bidouilles/bGeigieNano/assembly/xGeigieNano.jpg

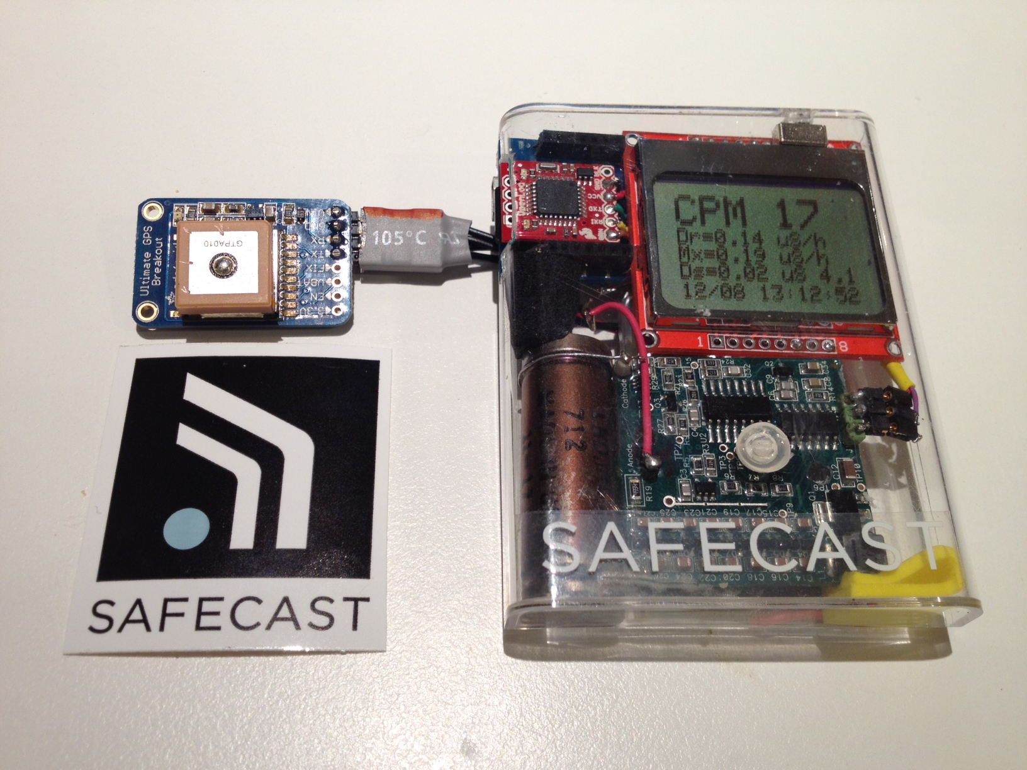
assembly/xGeigieNano.jpg
