bidouilles/bGeigieNano/assembly/xGeigieNano_kit.jpg

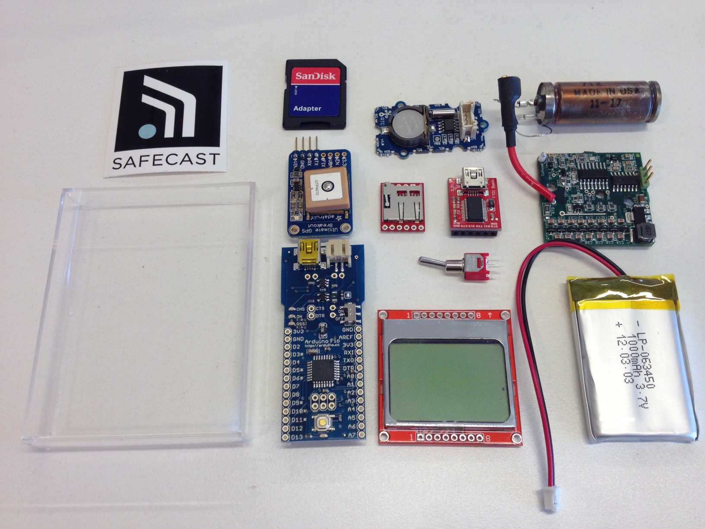
assembly/xGeigieNano_kit.jpg
