bidouilles/bGeigieNano/bGeigieNano.ino

/*
   The bGeigie-nano
   A device for car-borne radiation measurement (aka Radiation War-driving).

   Copyright (c) 2012, Lionel Bergeret
   Copyright (c) 2011, Robin Scheibler aka FakuFaku, Christopher Wang aka Akiba
   All rights reserved.

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
   THIS SOFTWARE IS PROVIDED BY THE COPYRIGHT HOLDERS AND CONTRIBUTORS "AS IS" AND
   ANY EXPRESS OR IMPLIED WARRANTIES, INCLUDING, BUT NOT LIMITED TO, THE IMPLIED
   WARRANTIES OF MERCHANTABILITY AND FITNESS FOR A PARTICULAR PURPOSE ARE
   DISCLAIMED. IN NO EVENT SHALL <COPYRIGHT HOLDER> BE LIABLE FOR ANY
   DIRECT, INDIRECT, INCIDENTAL, SPECIAL, EXEMPLARY, OR CONSEQUENTIAL DAMAGES
   (INCLUDING, BUT NOT LIMITED TO, PROCUREMENT OF SUBSTITUTE GOODS OR SERVICES;
   LOSS OF USE, DATA, OR PROFITS; OR BUSINESS INTERRUPTION) HOWEVER CAUSED AND
   ON ANY THEORY OF LIABILITY, WHETHER IN CONTRACT, STRICT LIABILITY, OR TORT
   (INCLUDING NEGLIGENCE OR OTHERWISE) ARISING IN ANY WAY OUT OF THE USE OF THIS
   SOFTWARE, EVEN IF ADVISED OF THE POSSIBILITY OF SUCH DAMAGE.
*/

#include <limits.h>
#include <SoftwareSerial.h>
#include <math.h>
#include <stdlib.h>
#include <avr/wdt.h>
#include <EEPROM.h>
#include "TinyGPS.h"

#include "NanoSetup.h"
#include "NanoConfig.h"
#include "NanoDebug.h"

// OLED settings --------------------------------------------------------------
#if ENABLE_SSD1306
#ifndef OLED_SPI_MODE
#include <Wire.h>
#endif
#include <Adafruit_GFX.h>
#include <Adafruit_SSD1306.h>

#ifdef OLED_SPI_MODE
Adafruit_SSD1306 display(OLED_DATA, OLED_CLK, OLED_DC, OLED_RESET, OLED_CS);
#else
Adafruit_SSD1306 display(OLED_RESET);
#endif

#if (SSD1306_LCDHEIGHT != 32)
#error("Height incorrect, please fix Adafruit_SSD1306.h!");
#endif

#if (_SS_MAX_RX_BUFF < 128)
#error "SoftwareSerial RX buffer too small for TinyGPS NMEA sentences. Set _SS_MAX_RX_BUFF >= 128 in SoftwareSerial.h."
#endif

// For distance computation
bool gps_fix_first = true;
float gps_last_lon = 0, gps_last_lat = 0;
unsigned long int gps_distance = 0;
#endif

// Geiger settings ------------------------------------------------------------
#define TIME_INTERVAL 5000
#define LINE_SZ 120  // BNRDD with all numeric fields at max width hits ~120 B
#define BUFFER_SZ 12
#define STRBUFFER_SZ 32
#define NX (60000 / TIME_INTERVAL) // 1-minute sliding window in TIME_INTERVAL-sized bins
#define AVAILABLE 'A'  // indicates geiger data are ready (available)
#define VOID      'V'  // indicates geiger data not ready (void)

// log file headers
#define LOGFILE_HEADER "# NEW LOG\n# format="
char logfile_name[13];  // placeholder for filename
bool logfile_ready = false;

// geiger statistics
unsigned long shift_reg[NX] = {0};
unsigned long reg_index = 0;
unsigned long total_count = 0;
unsigned long max_count = 0;
unsigned long uptime = 0;
int str_count = 0;
char geiger_status = VOID;

// the line buffer for serial receive and send
static char line[LINE_SZ];
static char strbuffer[STRBUFFER_SZ];

// Pulse counter --------------------------------------------------------------
#if ENABLE_HARDWARE_COUNTER
// Hardware counter
#include "HardwareCounter.h"
HardwareCounter hwc(HARDWARE_COUNTER_TIMER1, TIME_INTERVAL);
#else
// Interrupt counter
#include "InterruptCounter.h"
#endif

#if ENABLE_HARDWARE_COUNTER
#if ENABLE_SLEEPMODE
#define IS_READY (1)
#else
#define IS_READY (hwc.available())
#endif
#else
#define IS_READY (interruptCounterAvailable())
#endif

// Last counter value, for delta-based sampling that does not race with
// the hardware reset.
COUNTER_TYPE prev_count = 0;

// OpenLog settings -----------------------------------------------------------
#if ENABLE_OPENLOG
#define OPENLOG_RETRY 200
SoftwareSerial OpenLog(OPENLOG_RX_PIN, OPENLOG_TX_PIN);
static const int resetOpenLog = OPENLOG_RST_PIN;
#endif
bool openlog_ready = false;

// Gps settings ------------------------------------------------------------
TinyGPS gps(true);
#define GPS_INTERVAL 1000
char gps_status = VOID;

#if ENABLE_SOFTGPS
SoftwareSerial gpsSerial(GPS_RX_PIN, GPS_TX_PIN);
#endif

// Gps data buffers
static char lat[BUFFER_SZ];
static char lon[BUFFER_SZ];

// MTK33x9 chipset
#define PMTK_SET_NMEA_UPDATE_1HZ "$PMTK220,1000*1F"
#define PMTK_SET_NMEA_OUTPUT_ALLDATA "$PMTK314,1,1,1,1,1,1,0,0,0,0,0,0,0,0,0,0,0,0,0*28"
#define PMTK_SET_NMEA_OUTPUT_RMCGGA "$PMTK314,0,1,0,1,0,0,0,0,0,0,0,0,0,0,0,0,0,0,0*28"
#define SBAS_ENABLE "$PMTK313,1*2E\r\n"
#define DGPS_WAAS_ON "$PMTK301,2*2E\r\n"

#if ENABLE_STATIC_GPS
#include <avr/pgmspace.h>
// GPS test sentences
char strGPRMC[] PROGMEM = "$GPRMC,201547.000,A,3014.5527,N,09749.5808,W,0.24,163.05,040109,,*1A";
char strGPGGA[] PROGMEM = "$GPGGA,201548.000,3014.5529,N,09749.5808,W,1,07,1.5,225.6,M,-22.5,M,18.8,0000*78";
char *teststrs[2] = {strGPRMC, strGPGGA};

static void sendstring(TinyGPS &gps, const PROGMEM char *str)
{
  while (true)
  {
    char c = pgm_read_byte_near(str++);
    if (!c) break;
    gps.encode(c);
  }
  gps.encode('\r');
  gps.encode('\n');
}
#endif

// Function definitions ---------------------------------------------------------
// Atmel Tips and Tricks: 3.6 Tip #6 – Access types: Static
static unsigned long cpm_gen();
static bool gps_gen_filename(TinyGPS &gps, char *buf);
static bool gps_gen_timestamp(TinyGPS &gps, char *buf, unsigned long cpm, unsigned long cpb);
static char checksum(char *s, int N);
#if ENABLE_OPENLOG
static void setupOpenLog();
static void createFile(char *fileName);
#endif
static void gps_program_settings();
static float read_voltage(int pin);
static unsigned long elapsedTime(unsigned long startTime);
#if ENABLE_100M_TRUNCATION
static void truncate_100m(char *latitude, char *longitude);
#endif

// Sleep mode -----------------------------------------------------------------
#if ENABLE_SLEEPMODE
#include <avr/sleep.h>
#include <avr/power.h>

volatile int f_wdt=1;

ISR(WDT_vect)
{
  if(f_wdt == 0)
  {
    f_wdt=1;
  }
  else
  {
    DEBUG_PRINTLN("WARNING: WDT Overrun");
  }
}

void enableSleepTimer(void)
{
  cli();
  wdt_reset();

  // Setup WDT
  // Clear the reset flag
  MCUSR &= ~(1<<WDRF);

  // Set WDCE (4 clock cycles updates)
  WDTCSR |= (1<<WDCE) | (1<<WDE);

  // Set new watchdog timeout prescaler value
  WDTCSR = 1<<WDP3; // 4.0 seconds

  // Enable the WD interrupt
  WDTCSR |= _BV(WDIE);

  sei();
}

void disableSleepTimer(void)
{
  cli();
  wdt_reset();

  // Setup WDT
  // Clear the reset flag
  MCUSR &= ~(1<<WDRF);

  // Keep old prescaler setting to prevent unintentional time-out
  WDTCSR |= (1<<WDCE) | (1<<WDE);

  // Disable the WD interrupt
  WDTCSR |= 0x00;

  sei();
}

void enterSleep(void)
{
  power_all_disable();
  set_sleep_mode(SLEEP_MODE_STANDBY); // keep oscillator active

  // Enable and enter sleep mode
  sleep_enable();
  sleep_mode();

  // The program will continue from here after the WDT timeout

  // Disable sleep and re-enable the peripherals
  sleep_disable();
  power_all_enable();
}
#endif

// Nano Settings --------------------------------------------------------------
static ConfigType config;
static DoseType dose;
#if ENABLE_OPENLOG
NanoSetup nanoSetup(OpenLog, config, dose, line, LINE_SZ);
#endif

// ****************************************************************************
// Setup
// ****************************************************************************
void setup()
{
  pinMode(GPS_LED_PIN, OUTPUT);
  pinMode(GEIGIE_TYPE_PIN, INPUT);

  Serial.begin(9600);

#ifndef ENABLE_SLEEPMODE
  // enable and reset the watchdog timer
  wdt_enable(WDTO_8S);
  wdt_reset();
#endif

#if ENABLE_OPENLOG
  // Load EEPROM settings. nanoSetup holds an OpenLog reference internally,
  // so it can only be constructed when OpenLog is compiled in.
  nanoSetup.initialize();

  DEBUG_PRINTLN("Initializing OpenLog.");
  OpenLog.begin(9600);
  setupOpenLog();
  if (openlog_ready) {
    nanoSetup.loadFromFile("SAFECAST.TXT");
  }
#endif

  DEBUG_PRINTLN("Initializing pulse counter.");

#if ENABLE_HARDWARE_COUNTER
  // Start the Pulse Counter!
  hwc.start();
  prev_count = hwc.count();
#else
  // Create pulse counter
  interruptCounterSetup(INTERRUPT_COUNTER_PIN, TIME_INTERVAL);

  // And now Start the Pulse Counter!
  interruptCounterReset();
  prev_count = interruptCounterCount();
#endif

#if ENABLE_SOFTGPS
  DEBUG_PRINTLN("Initializing GPS.");
  gpsSerial.begin(9600);

  // Put GPS serial in listen mode
  gpsSerial.listen();

  // initialize and program the GPS module
  gps_program_settings();
#endif

  DEBUG_PRINT("Devide id = ");
  DEBUG_PRINTLN(config.device_id);

#if ENABLE_EEPROM_DOSE
  EEPROM_readAnything(BMRDD_EEPROM_DOSE, dose);
  if (dose.total_time != 0) {
    dtostrf((float)( ((dose.total_count/(dose.total_time/60.0))/config.cpm_factor) * (dose.total_time/3600.0) ), 0, 2, strbuffer);
    DEBUG_PRINT("Total dose = ");
    DEBUG_PRINT(strbuffer);
    DEBUG_PRINTLN(" uSv");
  } else {
    DEBUG_PRINTLN("Total dose = 0.00 uSv");
  }
#endif

  // setup analog reference to read battery and boost voltage
  analogReference(INTERNAL);

#if ENABLE_SLEEPMODE
  enableSleepTimer();
#endif

#if ENABLE_SSD1306
  display.begin(SSD1306_SWITCHCAPVCC, 0x3C);

  // show splashscreen logo
  display.display();

  delay(1000);

  // show 2nd splashscreen
  display.clearDisplay();

  display.setTextColor(WHITE);
  display.setTextSize(1);
  sprintf_P(strbuffer, PSTR("Geigie Nano %s"), NANO_VERSION);
  display.setCursor((128-((strlen(strbuffer)+1)*6))/2, 0);
  if (config.type == GEIGIE_TYPE_B) {
    display.print("b");
  } else {
    display.print("x");
  }
  display.print(strbuffer);

  display.setTextSize(2);
  display.setCursor(40, 8);
  sprintf_P(strbuffer, PSTR("#%04d"), config.device_id);
  display.print(strbuffer);

  display.setTextSize(1);
  if (strlen(config.user_name)) {
    display.setCursor((128-(strlen(config.user_name)*6))/2, 24); // textsize*8
    display.print(config.user_name);
  }
  display.display();
#endif

  DEBUG_PRINTLN("Setup completed.");
}

// ****************************************************************************
// Main loop
// ****************************************************************************
void loop()
{
  bool gpsReady = false;

#if ENABLE_GEIGIE_SWITCH
  // Check geigie mode switch
  if (analogRead(GEIGIE_TYPE_PIN) > GEIGIE_TYPE_THRESHOLD) {
    config.type = GEIGIE_TYPE_X; // xGeigie
  } else {
    config.type = GEIGIE_TYPE_B; // bGeigie
  }
#endif

#if ENABLE_SLEEPMODE
  if(f_wdt == 1)
  {
    disableSleepTimer();
#endif

#if ENABLE_SOFTGPS
  // Put GPS serial in listen mode
  gpsSerial.listen();
#endif

  // For one second we parse GPS sentences
  for (unsigned long start = millis(); (elapsedTime(start) < GPS_INTERVAL) and !IS_READY;)
  {
#if ENABLE_STATIC_GPS
    for (int i=0; i<2; ++i)
    {
      sendstring(gps, teststrs[i]);
    }
#else
#if ENABLE_SOFTGPS
    while (gpsSerial.available())
    {
      char c = gpsSerial.read();
#else
    while (Serial.available())
    {
      char c = Serial.read();
#endif

#if ENABLE_GPS_NMEA_LOG
      Serial.print(c); // uncomment this line if you want to see the GPS data flowing
#endif
      if (gps.encode(c)) // Did a new valid sentence come in?
        gpsReady = true;
    }
#endif
  }

#if ENABLE_SLEEPMODE
  // Will wakeup in 4 seconds from now
  enableSleepTimer();
#endif

  if ((gpsReady) || (gps_status == AVAILABLE)) {
    digitalWrite(GPS_LED_PIN, HIGH);
  } else {
    digitalWrite(GPS_LED_PIN, LOW);
  }

  // generate CPM every TIME_INTERVAL seconds
  if IS_READY {
      unsigned long cpm=0, cpb=0;

#ifndef ENABLE_SLEEPMODE
      // first, reset the watchdog timer
      wdt_reset();
#endif

      // read the current free-running counter, then derive this bin's count
      // by diffing against the previous read. The hardware is never reset
      // between samples, so pulses arriving during the read can't be lost.
      // The unsigned subtraction is correct across one wrap of COUNTER_TYPE.
#if ENABLE_HARDWARE_COUNTER
      COUNTER_TYPE this_count = hwc.count();
#else
      COUNTER_TYPE this_count = interruptCounterCount();
#endif
      cpb = (COUNTER_TYPE)(this_count - prev_count);
      prev_count = this_count;

      // insert count in sliding window and compute CPM
      shift_reg[reg_index] = cpb;     // put the count in the correct bin
      reg_index = (reg_index+1) % NX; // increment register index
      cpm = cpm_gen();                // compute sum over all bins

      // update the total counter
      total_count += cpb;
      uptime += TIME_INTERVAL / 1000;

      // update max cpm
      if (cpm > max_count) max_count = cpm;

#if ENABLE_EEPROM_DOSE
      dose.total_count += cpb;
      dose.total_time += TIME_INTERVAL / 1000;
      // Persist on every WRITETIME elapsed seconds. Tracking a separate
      // counter avoids the modulus pitfall — % would silently never fire
      // if TIME_INTERVAL doesn't evenly divide WRITETIME.
      static unsigned long dose_secs_since_write = 0;
      dose_secs_since_write += TIME_INTERVAL / 1000;
      if (dose_secs_since_write >= BMRDD_EEPROM_DOSE_WRITETIME) {
        EEPROM_writeAnything(BMRDD_EEPROM_DOSE, dose);
        dose_secs_since_write = 0;
      }
#endif

      // set status of Geiger
      if (str_count < NX)
      {
        geiger_status = VOID;
        str_count++;
      } else if (cpm == 0) {
        geiger_status = VOID;
      } else {
        geiger_status = AVAILABLE;
      }

#if ENABLE_WAIT_GPS_FOR_LOG
      if ((!logfile_ready) && (gps_status == AVAILABLE))
#else
      if (!logfile_ready)
#endif
      {
         if (gps_gen_filename(gps, logfile_name)) {
           logfile_ready = true;

#if ENABLE_OPENLOG
           DEBUG_PRINTLN("Create new logfile.");
           createFile(logfile_name);
           // print header to serial
           sprintf_P(strbuffer, PSTR(LOGFILE_HEADER));
           OpenLog.print(strbuffer);
           DEBUG_PRINT(strbuffer);
           sprintf_P(strbuffer, PSTR(NANO_VERSION));
           OpenLog.print(strbuffer);
           DEBUG_PRINT(strbuffer);

#ifdef ENABLE_LND_DEADTIME
           sprintf_P(strbuffer, PSTR("nano\n# deadtime=on\n"));
#else
           sprintf_P(strbuffer, PSTR("nano\n"));
#endif
           OpenLog.print(strbuffer);
           DEBUG_PRINT(strbuffer);

           // Settings dump
           sprintf_P(line, PSTR("# nm=%s,tz=%d,cn=%s,cpmf=%d,st=%d,ss=%d,sh=%d,sm=%d\n"),
               config.user_name,
               config.timezone,
               config.country_code,
               (int)config.cpm_factor,
               config.sensor_type,
               config.sensor_shield,
               config.sensor_height,
               config.sensor_mode);
           OpenLog.print(line);
           Serial.print(line);
#endif
         }
      }

      // generate timestamp. only update the start time if
      // we printed the timestamp. otherwise, the GPS is still
      // updating so wait until its finished and generate timestamp
      memset(line, 0, LINE_SZ);
      gps_gen_timestamp(gps, line, cpm, cpb);

      // Printout line
      Serial.println(line);

#if ENABLE_OPENLOG
      if ((logfile_ready) && (GEIGIE_TYPE_B == config.type)) {
        // Put OpenLog serial in listen mode
        OpenLog.listen();
        OpenLog.println(line);

#if ENABLE_DIAGNOSTIC
        dtostrf(read_voltage(VOLTAGE_PIN), 0, 1, strbuffer);
        OpenLog.print("$DIAG,");
        OpenLog.println(strbuffer);
#endif
      }
#endif
  }

#if ENABLE_SLEEPMODE
    // Leave some time to serial to flush data
    delay(100);

    // Clear the flag
    f_wdt = 0;

    // Re-enter sleep mode
    enterSleep();
  }
#endif

}

// ****************************************************************************
// Utility functions
// ****************************************************************************

/* elapsed time since startTime — unsigned subtraction wraps correctly
   across the 49.7-day millis() rollover, so no rollover branch needed. */
unsigned long elapsedTime(unsigned long startTime) {
  return millis() - startTime;
}

#if ENABLE_OPENLOG
/* wait for openlog prompt */
bool waitOpenLog(bool commandMode) {
  int safeguard = 0;
  bool result = false;

  while(safeguard < OPENLOG_RETRY) {
    safeguard++;
    if(OpenLog.available())
      if(OpenLog.read() == (commandMode ? '>':'<')) break;
    delay(10);
  }

  if (safeguard >= OPENLOG_RETRY) {
    DEBUG_PRINTLN("OpenLog init failed ! Check if the CONFIG.TXT is set to 9600,26,3,2");
  } else {
    DEBUG_PRINTLN(" - ready");
    result = true;
  }

  return result;
}

/* setups up the software serial, resets OpenLog */
void setupOpenLog() {
  pinMode(resetOpenLog, OUTPUT);
  OpenLog.listen();

  // reset OpenLog
  DEBUG_PRINTLN(" - reset");
  digitalWrite(resetOpenLog, LOW);
  delay(100);
  digitalWrite(resetOpenLog, HIGH);

  if (!waitOpenLog(true)) {
    logfile_ready = true;
  } else {
    openlog_ready = true;
  }
}

/* create a new file */
void createFile(char *fileName) {
  int result = 0;

  OpenLog.listen();

  do {
    result = 0;

    do {
#ifndef ENABLE_SLEEPMODE
      // reset the watchdog timer
      wdt_reset();
#endif

      DEBUG_PRINT(" - append ");
      DEBUG_PRINTLN(fileName);

      OpenLog.print("append ");
      OpenLog.print(fileName);
      OpenLog.write(13); //This is \r

      // wait for OpenLog to indicate file is open and ready for writing
      DEBUG_PRINTLN(" - wait");
      if (!waitOpenLog(false)) {
        DEBUG_PRINTLN("Append file failed");
        break;
      }
      result = 1;
    } while (0);

    if (0 == result) {
      // reset OpenLog
      DEBUG_PRINTLN(" - reset");
      digitalWrite(resetOpenLog, LOW);
      delay(100);
      digitalWrite(resetOpenLog, HIGH);

      // Wait for OpenLog to return to waiting for a command
      waitOpenLog(true);
    }
  } while (0 == result);

  //OpenLog is now waiting for characters and will record them to the new file
}
#endif

/* compute check sum of N bytes in array s */
char checksum(char *s, int N)
{
  int i = 0;
  char chk = s[0];

  for (i=1 ; i < N ; i++)
    chk ^= s[i];

  return chk;
}

/* compute cpm */
unsigned long cpm_gen()
{
   unsigned int i;
   unsigned long c_p_m = 0;

   // sum up
   for (i=0 ; i < NX ; i++)
     c_p_m += shift_reg[i];

#ifdef ENABLE_LND_DEADTIME
   // deadtime compensation (medcom international)
   c_p_m = (unsigned long)((float)c_p_m/(1-(((float)c_p_m*1.8833e-6))));
#endif

   return c_p_m;
}

/* generate log filename */
bool gps_gen_filename(TinyGPS &gps, char *buf) {
  int year = 2012;
  byte month = 0, day = 0, hour = 0, minute = 0, second = 0, hundredths = 0;
  unsigned long age;

  gps.crack_datetime(&year, &month, &day, &hour, &minute, &second, &hundredths, &age);
  if (TinyGPS::GPS_INVALID_AGE == age) {
    return false;
  }

  // Create the filename for that drive
  sprintf_P(buf, PSTR("%04d%02d%02d.log"),config.device_id, month, day);

  return true;
}

/* convert long integer from TinyGPS to string "xxxxx.xxxx" */
void get_coordinate_string(bool is_latitude, unsigned long val, char *buf)
{
  unsigned long left = 0;
  unsigned long right = 0;

  left = val / 100000;
  right = (val - left*100000)/10;
  if (is_latitude) {
    sprintf_P(buf, PSTR("%04ld.%04ld"), left, right);
  } else {
    sprintf_P(buf, PSTR("%05ld.%04ld"), left, right);
  }
}

/* convert long integer from TinyGPS to float WGS84 degrees */
float get_wgs84_coordinate(unsigned long val)
{
  double result = 0.0;
  result = val/10000000.0;
  result = ((result-(int)result)/60.0)*100 + (int)result;
  return (float)result;
}

/* generate log result line */
bool gps_gen_timestamp(TinyGPS &gps, char *buf, unsigned long cpm, unsigned long cpb)
{
  int year = 2012;
  byte month = 0, day = 0, hour = 0, minute = 0, second = 0, hundredths = 0;
  long int x = 0, y = 0;
  float faltitude = 0, fspeed = 0;
  unsigned short nbsat = 0;
  unsigned long precission = 0;
  unsigned long age;
  byte len, chk;
  char NS = 'N';
  char WE = 'E';
  static int toggle = 0;

  memset(lat, 0, BUFFER_SZ);
  memset(lon, 0, BUFFER_SZ);
  memset(strbuffer, 0, STRBUFFER_SZ);

  // get GPS date
  gps.crack_datetime(&year, &month, &day, &hour, &minute, &second, &hundredths, &age);
  if (TinyGPS::GPS_INVALID_AGE == age) {
    year = 2012, month = 0, day = 0, hour = 0, minute = 0, second = 0, hundredths = 0;
  }

  // get GPS position, altitude and speed
  gps.get_position(&x, &y, &age);
  if (!gps.status()) {
    gps_status = VOID;
  } else {
    gps_status = AVAILABLE;
  }
  faltitude = gps.f_altitude();
  fspeed = gps.f_speed_kmph();
  nbsat = gps.satellites();
  precission = gps.hdop();

  if (x < 0) { NS = 'S'; x = -x;}
  if (y < 0) { WE = 'W'; y = -y;}
  get_coordinate_string(true, x == TinyGPS::GPS_INVALID_ANGLE ? 0 : x, lat);
  get_coordinate_string(false, y == TinyGPS::GPS_INVALID_ANGLE ? 0 : y, lon);
  dtostrf(faltitude == TinyGPS::GPS_INVALID_F_ALTITUDE ? 0.0 : faltitude, 0, 2, strbuffer);

#if ENABLE_100M_TRUNCATION
  truncate_100m(lat, lon);
#endif

  // prepare the log entry
  memset(buf, 0, LINE_SZ);
  sprintf_P(buf, PSTR("$%s,%04d,%02d-%02d-%02dT%02d:%02d:%02dZ,%ld,%ld,%ld,%c,%s,%c,%s,%c,%s,%c,%ld,%d"),  \
              NANO_HEADER, \
              config.device_id, \
              year, month, day,  \
              hour, minute, second, \
              cpm, \
              cpb, \
              total_count, \
              geiger_status, \
              lat, NS,\
              lon, WE,\
              strbuffer, \
              gps_status, \
              precission == TinyGPS::GPS_INVALID_HDOP ? 0 : precission, \
              nbsat  == TinyGPS::GPS_INVALID_SATELLITES ? 0 : nbsat);

  len = strlen(buf);
  buf[len] = '\0';

  // generate checksum
  chk = checksum(buf+1, len);

  // add checksum to end of line before sending
  if (chk < 16)
    sprintf_P(buf + len, PSTR("*0%X"), (int)chk);
  else
    sprintf_P(buf + len, PSTR("*%X"), (int)chk);

#if ENABLE_SSD1306
  // compute distance
  if (gps.status()) {
    unsigned int trigger_dist = 25;
    float flat = get_wgs84_coordinate(x);
    float flon = get_wgs84_coordinate(y);

    if(fspeed > 5)
      // fpspeed/3.6 * 5s = 6.94 m
      trigger_dist = 5;
    if(fspeed > 10)
      trigger_dist = 10;
    if(fspeed > 15)
      trigger_dist = 20;

    if(gps_fix_first)
    {
      gps_last_lat = flat;
      gps_last_lon = flon;
      gps_fix_first = false;
    }
    else
    {
      // Distance in meters
      unsigned long int dist = (long int)TinyGPS::distance_between(flat, flon, gps_last_lat, gps_last_lon);

      if (dist > trigger_dist)
      {
        gps_distance += dist;
        gps_last_lat = flat;
        gps_last_lon = flon;
      }
    }
  }

  // ready to display the data on screen
  display.clearDisplay();
  int offset = 0;

  if (config.type == GEIGIE_TYPE_B) {
    // **********************************************************************
    // bGeigie mode
    // **********************************************************************
    // Display uptime — use locals so the GPS hour/minute survive for the
    // common "Display date" block below (otherwise the date line would
    // print uptime hh:mm with GPS day/month, looking like a real timestamp).
    byte uph = uptime / 3600;
    byte upm = uptime / 60 - uph * 60;
    sprintf_P(strbuffer, PSTR("%02dh%02dm"), uph, upm);
    display.setCursor(92, offset+16);
    display.setTextSize(1);
    display.setTextColor(WHITE);
    display.println(strbuffer);

    // Display CPM (with deadtime compensation)
    display.setCursor(0, offset);
    display.setTextSize(2);
    if (VOID == geiger_status) {
      display.setTextColor(BLACK, WHITE); // 'inverted' text
    } else {
      display.setTextColor(WHITE);
    }
    // kCPM (>=1000) uses float division — the previous (cpm/1000) was an
    // integer divide that dropped the fractional digit (1750 -> "1.0k").
    if (cpm >= 10000) {
      dtostrf((float)cpm / 1000.0, 0, 1, strbuffer);
      display.print(strbuffer);
      sprintf_P(strbuffer, PSTR("kCPM"));
    } else if (cpm >= 1000) {
      dtostrf((float)cpm / 1000.0, 0, 2, strbuffer);
      display.print(strbuffer);
      sprintf_P(strbuffer, PSTR("kCPM"));
    } else {
      dtostrf((float)cpm, 0, 0, strbuffer);
      display.print(strbuffer);
      sprintf_P(strbuffer, PSTR(" CPM"));
    }
    display.print(strbuffer);

    // Display SD, GPS and Geiger states
    if (openlog_ready) {
      display.setTextColor(WHITE);
    } else {
      if (toggle) {
        display.setTextColor(BLACK, WHITE); // 'inverted' text
      } else {
        display.setTextColor(WHITE);
      }
    }
    display.setTextSize(1);
    if (!gps.status()) {
      display.setCursor(92, offset);
      sprintf_P(strbuffer, PSTR("No GPS"));
      display.println(strbuffer);
    } else {
      display.setCursor(116, offset);
      sprintf(strbuffer, "^%X", nbsat);
      display.println(strbuffer);
    }

    // Display uSv/h
    display.setTextColor(WHITE);
    display.setCursor(0, offset+16); // textsize*8
    if (config.mode == GEIGIE_MODE_USVH) {
      // Auto-switch to mSv/h above 1000 uSv/h (1 mSv/h ≈ 334k CPM at LND default).
      // Reduce to 2 decimals above 10 uSv/h to keep the line from overflowing.
      float usvh = (float)cpm / config.cpm_factor;
      if (usvh >= 1000.0) {
        dtostrf(usvh / 1000.0, 0, 2, strbuffer);
        display.print(strbuffer);
        sprintf_P(strbuffer, PSTR(" mSv/h"));
      } else if (usvh >= 10.0) {
        dtostrf(usvh, 0, 2, strbuffer);
        display.print(strbuffer);
        sprintf_P(strbuffer, PSTR(" uSv/h"));
      } else {
        dtostrf(usvh, 0, 3, strbuffer);
        display.print(strbuffer);
        sprintf_P(strbuffer, PSTR(" uSv/h"));
      }
      display.println(strbuffer);
    }
    else if (config.mode == GEIGIE_MODE_BQM2) {
      dtostrf((float)(cpm*config.bqm_factor), 0, 3, strbuffer);
      display.print(strbuffer);
      sprintf_P(strbuffer, PSTR(" Bq/m2"));
      display.println(strbuffer);
    }

    if (toggle) {
      // Display distance
      dtostrf((float)(gps_distance/1000.0), 0, 1, strbuffer);
      display.setCursor(116-(strlen(strbuffer)*6), offset+8); // textsize*8
      display.print(strbuffer);
      sprintf_P(strbuffer, PSTR("km"));
      display.println(strbuffer);
    } else {
      // Display altidude
      if (gps.status()) {
        dtostrf(faltitude, 0, 0, strbuffer);
      } else {
        sprintf_P(strbuffer, PSTR("--"));
      }
      display.setCursor(122-(strlen(strbuffer)*6), offset+8); // textsize*8
      display.print(strbuffer);
      display.println("m");
    }
  } 
  else if (config.type == GEIGIE_TYPE_X) {
    // **********************************************************************
    // xGeigie mode
    // **********************************************************************

    // Display uSv/h
    if (VOID == geiger_status) {
      display.setTextColor(BLACK, WHITE); // 'inverted' text
    } else {
      display.setTextColor(WHITE);
    }
    display.setTextSize(2);
    display.setCursor(0, offset); // textsize*8
    {
      // Same mSv/h auto-switch as the bGeigie mode display.
      float ush = (float)cpm / config.cpm_factor;
      if (ush >= 1000.0) {
        dtostrf(ush / 1000.0, 0, 2, strbuffer);
        display.print(strbuffer);
        sprintf_P(strbuffer, PSTR(" mS/h"));
      } else if (ush >= 10.0) {
        dtostrf(ush, 0, 2, strbuffer);
        display.print(strbuffer);
        sprintf_P(strbuffer, PSTR(" uS/h"));
      } else {
        dtostrf(ush, 0, 3, strbuffer);
        display.print(strbuffer);
        sprintf_P(strbuffer, PSTR(" uS/h"));
      }
      display.print(strbuffer);
    }

    display.setCursor(0, offset+16);
    display.setTextSize(1);
    display.setTextColor(WHITE);
    if (toggle) {
      // Display CPM. Same int-divide fix + >=10000 branch as bGeigie mode.
      if (cpm >= 10000) {
        dtostrf((float)cpm / 1000.0, 0, 1, strbuffer);
        display.print(strbuffer);
        sprintf_P(strbuffer, PSTR("kCPM "));
      } else if (cpm >= 1000) {
        dtostrf((float)cpm / 1000.0, 0, 2, strbuffer);
        display.print(strbuffer);
        sprintf_P(strbuffer, PSTR("kCPM "));
      } else {
        dtostrf((float)cpm, 0, 0, strbuffer);
        display.print(strbuffer);
        sprintf_P(strbuffer, PSTR(" CPM "));
      }
      display.print(strbuffer);

      // Display bq/m2
      dtostrf((float)(cpm*config.bqm_factor), 0, 0, strbuffer);
      display.print(strbuffer);
      sprintf_P(strbuffer, PSTR(" Bq/m2"));
      display.print(strbuffer);
    } else {
      // Total dose and max count
      sprintf_P(strbuffer, PSTR("Mx="));
      display.print(strbuffer);
      dtostrf((float)(max_count/config.cpm_factor), 0, 1, strbuffer);
      display.print(strbuffer);
      sprintf_P(strbuffer, PSTR("uS/h "));
      display.print(strbuffer);
      sprintf_P(strbuffer, PSTR("Ds="));
      display.print(strbuffer);
      dtostrf((float)( ((dose.total_count/(dose.total_time/60.0))/config.cpm_factor) * (dose.total_time/3600.0) ), 0, 0, strbuffer);
      display.print(strbuffer);
      sprintf_P(strbuffer, PSTR("uS"));
      display.print(strbuffer);
    }
  } else {
    // Wrong mode
    display.setCursor(0, offset);
    display.setTextSize(2);
    display.setTextColor(BLACK, WHITE); // 'inverted' text
    sprintf_P(strbuffer, PSTR("Wrong mode !"));
    display.print(strbuffer);
  }

  // **********************************************************************
  // Common display parts
  // **********************************************************************

  // Display date
  sprintf_P(strbuffer, PSTR("%02d/%02d %02d:%02d:%02d"),  \
        day, month, \
        hour, minute, second);
  display.setCursor(0, offset+24); // textsize*8
  display.setTextSize(1);
  display.setTextColor(WHITE);
  display.println(strbuffer);

  // Display battery indicator
  // Range = [3.5v to 4.3v]
  int battery = ((read_voltage(VOLTAGE_PIN)-3.5)*8/0.8);
  if (battery < 0) battery = 0;
  if (battery > 8) battery = 8;
  display.drawRect(116, offset+24, 12, 7, WHITE);
  display.fillRect(118, offset+26, battery, 3, WHITE);

  display.display();
#endif

  // Display items toggling
  toggle ^= 1;

  return (gps_status == AVAILABLE);
}

/* setup the GPS module to 1Hz and RMC+GGA messages only */
void gps_program_settings()
{
#if ENABLE_MEDIATEK
  memset(line, 0, LINE_SZ);
  sprintf_P(line, PSTR(PMTK_SET_NMEA_OUTPUT_RMCGGA));
  gpsSerial.println(line);

  memset(line, 0, LINE_SZ);
  sprintf_P(line, PSTR(PMTK_SET_NMEA_UPDATE_1HZ));
  gpsSerial.println(line);

  memset(line, 0, LINE_SZ);
  sprintf_P(line, PSTR(SBAS_ENABLE));
  gpsSerial.println(line);

  memset(line, 0, LINE_SZ);
  sprintf_P(line, PSTR(DGPS_WAAS_ON));
  gpsSerial.println(line);
#endif

#if ENABLE_SKYTRAQ
  // all GPS command taken from datasheet
  // "Binary Messages Of SkyTraq Venus 6 GPS Receiver"

  // set GGA and RMC output at 1Hz
  uint8_t GPS_MSG_OUTPUT_GGARMC_1S[9] = { 0x08, 0x01, 0x00, 0x00, 0x00, 0x01, 0x00, 0x00, 0x01 }; // with update to RAM and FLASH
  uint16_t GPS_MSG_OUTPUT_GGARMC_1S_L = 9;

  // Power Save mode (not sure what it is doing at the moment
  uint8_t GPS_MSG_PWR_SAVE[3] = { 0x0C, 0x01, 0x01 }; // update to FLASH too
  uint16_t GPS_MSG_PWR_SAVE_L = 3;

  // wait for GPS to start
  while(!gpsSerial.available())
    delay(10);

  // send all commands
  gps_send_message(GPS_MSG_OUTPUT_GGARMC_1S, GPS_MSG_OUTPUT_GGARMC_1S_L);
  gps_send_message(GPS_MSG_PWR_SAVE, GPS_MSG_PWR_SAVE_L);
#endif
}

void gps_send_message(const uint8_t *msg, uint16_t len)
{
  uint8_t chk = 0x0;
  // header
  gpsSerial.write(0xA0);
  gpsSerial.write(0xA1);
  // send length
  gpsSerial.write(len >> 8);
  gpsSerial.write(len & 0xff);
  // send message
  for (unsigned int i = 0 ; i < len ; i++)
  {
    gpsSerial.write(msg[i]);
    chk ^= msg[i];
  }
  // checksum
  gpsSerial.write(chk);
  // end of message
  gpsSerial.write(0x0D);
  gpsSerial.write(0x0A);
  gpsSerial.write('\n');
}

/* retrieve battery voltage */
float read_voltage(int pin)
{
  static float voltage_divider = (float)VOLTAGE_R2 / (VOLTAGE_R1 + VOLTAGE_R2);
  float result = (float)analogRead(pin)/1024 * 3.3 / voltage_divider;
  return result;
}

#if ENABLE_100M_TRUNCATION
/*
* Truncate the latitude and longitude according to
* Japan Post requirements
*
* This algorithm truncate the minute
* part of the latitude and longitude
* in order to rasterize the points on
* a 100x100m grid.
*/
void truncate_100m(char *latitude, char *longitude)
{
  unsigned long minutes;
  float latitude0;
  unsigned int longitude_trunc;

  /* latitude */
  // get minutes in one long int
  minutes = (unsigned long)(latitude[2]-'0')*100000
    + (unsigned long)(latitude[3]-'0')*10000
    + (unsigned long)(latitude[5]-'0')*1000
    + (unsigned long)(latitude[6]-'0')*100
    + (unsigned long)(latitude[7]-'0')*10
    + (unsigned long)(latitude[8]-'0');
  // truncate, for latutude, truncation factor is fixed
  minutes -= minutes % 546;
  // get this back in the string
  latitude[2] = '0' + (minutes/100000);
  latitude[3] = '0' + ((minutes%100000)/10000);
  latitude[5] = '0' + ((minutes%10000)/1000);
  latitude[6] = '0' + ((minutes%1000)/100);
  latitude[7] = '0' + ((minutes%100)/10);
  latitude[8] = '0' + (minutes%10);

  // compute the full latitude in radian
  latitude0 = ((float)(latitude[0]-'0')*10 + (latitude[1]-'0') + (float)minutes/600000.f)/180.*M_PI;

  /* longitude */
  // get minutes in one long int
  minutes = (unsigned long)(longitude[3]-'0')*100000
    + (unsigned long)(longitude[4]-'0')*10000
    + (unsigned long)(longitude[6]-'0')*1000
    + (unsigned long)(longitude[7]-'0')*100
    + (unsigned long)(longitude[8]-'0')*10
    + (unsigned long)(longitude[9]-'0');
  // compute truncation factor
  longitude_trunc = (unsigned int)((0.0545674090600784/cos(latitude0))*10000.);
  // truncate
  minutes -= minutes % longitude_trunc;
  // get this back in the string
  longitude[3] = '0' + (minutes/100000);
  longitude[4] = '0' + ((minutes%100000)/10000);
  longitude[6] = '0' + ((minutes%10000)/1000);
  longitude[7] = '0' + ((minutes%1000)/100);
  longitude[8] = '0' + ((minutes%100)/10);
  longitude[9] = '0' + (minutes%10);

}
#endif /* JAPAN_POST */
