bidouilles/bGeigieNano/NanoConfig.h

#ifndef _NANO_CONFIG_H_
#define _NANO_CONFIG_H_

//
// bGeigie Nano definitions
//

#define NANO_DEVICE_ID         0000
#define NANO_VERSION       "1.0.2"
#define NANO_HEADER        "BNRDD"
#define NANO_CPM_FACTOR        334
#define NANO_BQM2_FACTOR        37

//
// Enable or Disable features
//

#define ENABLE_DEBUG             1
#define ENABLE_DIAGNOSTIC        0
#define ENABLE_SSD1306           1
#define ENABLE_SOFTGPS           1
#define ENABLE_STATIC_GPS        0
#define ENABLE_HARDWARE_COUNTER  0
#define ENABLE_OPENLOG           1
#define ENABLE_WAIT_GPS_FOR_LOG  0
#define ENABLE_GPS_NMEA_LOG      0
#define ENABLE_100M_TRUNCATION   0
#define ENABLE_MEDIATEK          1
#define ENABLE_SKYTRAQ           0
#define ENABLE_EEPROM_DOSE       1
#define ENABLE_LND_DEADTIME      1 // enable dead-time compensation for LND7317
#define ENABLE_GEIGIE_SWITCH     0 // switch between bGeigie and xGeigie type
#define ENABLE_NANOKIT_PIN       1 // use the nano kit configuration

#if ENABLE_SSD1306 // high memory usage (avoid logs)
#undef ENABLE_DEBUG // disable debug log output
#endif

//
// Pins definition
//

#if ENABLE_NANOKIT_PIN
  #warning NANO KIT with OLED screen used !
  #define OLED_SPI_MODE // SPI mode enabled
  #define OLED_CLK 7
  #define OLED_DATA 6
  #define OLED_DC 5
  #define OLED_CS 4
  #define OLED_RESET 3
  #define GPS_RX_PIN 8
  #define GPS_TX_PIN 9
  #define OPENLOG_RX_PIN 10
  #define OPENLOG_TX_PIN 11
  #define OPENLOG_RST_PIN 12
#else
#if ENABLE_HARDWARE_COUNTER
  // Pin assignment for version 1.0.1
  #warning Hardware counter is used !
  #define OLED_RESET 4
  #define GPS_RX_PIN 6
  #define GPS_TX_PIN 7
  #define OPENLOG_RX_PIN 8
  #define OPENLOG_TX_PIN 9
  #define OPENLOG_RST_PIN 10
#else
  // Old Pin assignment for version 1.0.0
  #warning Interrupt counter is used !
  #define OLED_RESET 4
  #define GPS_RX_PIN 5
  #define GPS_TX_PIN 6
  #define OPENLOG_RX_PIN 7
  #define OPENLOG_TX_PIN 8
  #define OPENLOG_RST_PIN 9
#endif
#endif

#define GPS_LED_PIN 13

// HardwareCounter pin
// the timer1 pin on the 328p is D5
#define HARDWARE_COUNTER_TIMER1 5

// InterruptCounter pin
// 0 = D2, 1 = D3
#define INTERRUPT_COUNTER_PIN 0

// bGeigie <-> xGeigie switch pin
#define GEIGIE_TYPE_PIN A0
#define GEIGIE_TYPE_THRESHOLD 500

// Voltage divider
// GND -- R2 --A7 -- R1 -- VCC
// https://en.wikipedia.org/wiki/Voltage_divider
#define VOLTAGE_PIN A7
#define VOLTAGE_R1 9100
#define VOLTAGE_R2 1000

#endif
