bidouilles/bGeigieNano/(commit log)

2012-08-13 xGeigieNano first version with MTK3339 GPS, Nokia 5110 LCD, OpenLog and LND712 tube
2012-08-13 Add voltage divider formula for battery monitoring
2026-05-27 Counters: typedef COUNTER_TYPE and reset window inside count()
    Lifts the typedef from upstream "Ray interrupt fixes" so the main loop
    can sample via delta against the previous read (this_count - prev_count)
    instead of resetting the hardware between samples. Resets only the
    sampling window timer inside count()/interruptCounterCount(), leaving
    the actual count free to wrap. The unsigned-arithmetic delta works
    correctly across one wrap.
    Sets up the lost-interrupt fix that lands in the main loop next.
    [HardwareCounter.cpp, HardwareCounter.h, InterruptCounter.cpp, InterruptCounter.h]
2026-05-27 Main loop: delta-based pulse sampling to eliminate read/reset race
    Replaces "read count, then reset" with "read free-running count, diff
    against the previous read". The old sequence could lose pulses arriving
    in the window between count() and reset() — at high CPM that's a real
    undercount. The new sequence never resets the hardware, so no pulse is
    ever in flight when sampling. Unsigned subtraction handles one wrap of
    COUNTER_TYPE correctly (e.g. 3 - 0xFFFE == 5 for a 16-bit type).
    prev_count is primed in setup() right after each backend is started.
    Ported from Safecast/bGeigieNanoSafecast PR #58 (Ray's fix).
    [bGeigieNano.ino]
2026-05-27 Derive NX/uptime/dose from TIME_INTERVAL; integer-divide coordinate
    NX, uptime increments and dose-time increments all assumed the 5-second
    TIME_INTERVAL. They're now expressed in terms of TIME_INTERVAL so the
    1-minute CPM window and the dose accumulator stay correct if the
    interval ever changes.
    get_coordinate_string was doing a float divide-then-truncate to assign
    into an unsigned long; the integer divide is exact for these magnitudes
    and saves the AVR a fp call.
    [bGeigieNano.ino]
2026-05-27 NanoSetup: tolerate CRLF in SAFECAST.TXT; silence unsigned warnings
    The line-by-line reader only stopped on \n, so a SAFECAST.TXT saved
    with Windows line endings carried the trailing \r into the value
    (e.g. "210\r"), which atoi happens to survive but strcmp on string
    values would not. Now stops on either CR or LF. Also accepts either
    terminator when draining OpenLog's command echo, since the
    terminator differs by OpenLog firmware variant.
    Casts the atoi result to unsigned int in the device_id / alarm_level /
    sensor_height comparisons to match the ConfigType field types and
    silence the signed/unsigned compare warning.
    "lenght" -> "length" while touching the lines.
2026-05-27 Guard NanoSetup ctor under ENABLE_OPENLOG; add SS buffer compile check
    NanoSetup takes an OpenLog SoftwareSerial reference, but OpenLog itself
    is only declared inside #if ENABLE_OPENLOG, so the file currently
    fails to compile with ENABLE_OPENLOG=0. Wraps the static
    NanoSetup nanoSetup(...) declaration in the same guard, and moves
    nanoSetup.initialize() into the OPENLOG block alongside it (EEPROM
    config without OpenLog is degenerate anyway since SAFECAST.TXT
    overrides can't be loaded).
    Also adds a compile-time check that _SS_MAX_RX_BUFF >= 128 so the
    build fails loudly if the SoftwareSerial.h patch required by TinyGPS
    is missing, instead of silently dropping NMEA bytes at runtime.
    [bGeigieNano.ino]
2026-05-27 sample/SAFECAST.TXT: expand to cover every key NanoSetup parses
    The previous sample only set 4 of the 14 supported keys, so most
    device behavior was driven by EEPROM defaults that aren't visible to
    someone editing the SD card. Now lists every key NanoSetup.cpp
    understands, with the reference defaults from NanoConfig.h.
    Comments are on their own line — the parser doesn't strip inline
    comments, so an inline "# ..." after a string key (nm, cn) would be
    stored as part of the value. Modelled on the SD-card config from
    bGeigieNanoSafecast, restricted to keys this build actually parses.
2026-05-27 Replace ed.am Arduino-1.0 Makefile with arduino-cli wrapper
    The old Makefile required an Arduino 1.0.x install tree at ~/opt/arduino
    or /usr/share/arduino — neither installable nor supported on modern
    systems. The new wrapper drives arduino-cli (preferring one on PATH,
    falling back to the binary bundled inside Arduino IDE.app on macOS),
    targets arduino:avr:fio directly, points --libraries at the vendored
    Adafruit_GFX/SSD1306, and passes -D_SS_MAX_RX_BUFF=128 as a build
    property. That last flag is honored because the system SoftwareSerial.h
    guards its default with #ifndef, so the user no longer has to patch
    the Arduino install by hand.
    Targets: deps, build, upload/flash, monitor, hex, clea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
2026-05-27 Docs: README/CLAUDE.md for arduino-cli build and Safecast fixes
    README: replace the Arduino-1.0 build steps with the arduino-cli
    wrapper targets, and replace the manual SoftwareSerial.h patch note
    with the build-property override + compile-time-check explanation.
    CLAUDE.md: add the file (was untracked), update the build section
    for arduino-cli, document the delta-based counter sampling, note that
    the reference build is the nano kit 1.0 layout and that the PCB-kit
    hardware variants from upstream are deliberately not pulled, flag the
    BNRDD HDOP/satellites field-order regression as "do not pull".
2026-05-27 README: add bGeigieNanoKit v1.0r4 board view
    Reference build's PCB layout, designed by Lionel Bergeret, Pieter
    Franken and Naim Busek (CC BY-SA 3.0). Image taken from the
    bGeigieNanoSafecast hardware folder (the source .brd/.sch live there).
2026-05-27 SSD1306: SPI-only build drops Wire/TwoWire (~216 B RAM, ~2 KB flash)
    The vendored Adafruit_SSD1306 selects between SPI and I2C at runtime
    on sid != -1. Both paths were always compiled, so the linker kept the
    TwoWire object plus the three 32-byte TWI buffers in RAM — pure
    overhead since this build always uses OLED_SPI_MODE.
    Gates every Wire reference (the include and the four I2C call sites)
    behind #ifndef SSD1306_SPI_ONLY. The Makefile defines that flag
    alongside -D_SS_MAX_RX_BUFF=128 via build.extra_flags, so the library
    translation unit sees it too. The .ino's own #include <Wire.h> is
    gated on OLED_SPI_MODE to match.
    Memory report:
    flash 27084 -> 25138 B (-1946, 88% -> 81%)
    RAM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
2026-05-27 README: power budget with iRover HV; reconcile with empirical 57 mA
    The old budget summed 36 mA across Fio + OpenLog + GPS + OLED but
    omitted the Medcom iRover HV inverter that drives the LND-7317
    pancake (~21 mA, active regulation of the ~500 V plateau).
    Adds that line, restating the total as 57 mA. That matches the early
    empirical data point in commit 6eefd91 (~15 h on a fully-charged
    850 mAh cell: 850/15 ≈ 57 mA), so the corrected estimate finally
    agrees with what the device actually does.
    Recomputes the summary table at 57 mA instead of 36 mA, and notes
    the typical real-world derate (LDO cutoff, GPS re-acquisition spikes).
2026-05-27 README: modern flash-prebuilt-hex command
    Replaces the hard-coded /usr/bin/avrdude + /dev/ttyUSB0 invocation
    with an arduino-cli upload --input-file form (matches the rest of the
    README's tooling) and adds an avrdude fallback that drops the -V flag
    (verify-after-write is desirable), keeps -D (Optiboot does its own
    erase), and notes the macOS vs Linux port naming.
2026-05-27 Clean up benign warnings flagged by -Wall
    - bGeigieNano.ino:530: fix unterminated string literal in the non-
    deadtime branch of the log header (PSTR("nano\n)); -> PSTR("nano\n"));).
    The preprocessor was silently swallowing characters until the next ".
    - NanoSetup::loadFromFile takes const char * (no longer warns on
    passing a string literal).
    - Drop the dead 'static bool loadConfig(char*)' forward declaration —
    never defined.
    - Drop the unused 'safeguard' local in createFile.
    - Drop the unused 'counts' parameter from gps_gen_timestamp (was
    passed shift_reg[reg_index] but the body never read it); update
    the one caller and the forward decl.
    - Change trigger_dist to unsigned int so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
    [NanoSetup.cpp, NanoSetup.h, bGeigieNano.ino]
2026-05-27 Display: fix kCPM int-divide, add >=10k branch, uSv -> mSv auto-switch
    Two real bugs plus a polish item, ported from Rob Oudendijk's V1.1.3 /
    V1.1.4 / V1.1.5 series and Lionel Bergeret's later display rework
    (upstream 8228ddd). Adapted to the kit 1.0 reference build — no
    LOGALARM_LED_PIN, no strbuffer1, no render_measurement helper, no
    PCB-kit deps.
    1. (cpm/1000) was integer division because both operands were integer,
    so dtostrf received an already-truncated value (cpm=1750 displayed
    as "1.0k" instead of "1.7k"). Switches to (float)cpm / 1000.0.
    Same bug fixed in both the bGeigie kCPM display and the xGeigie
    secondary CPM display.
    2. Adds a >=10000 branch that shows 1-decima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
    [bGeigieNano.ino]
2026-05-27 Fixes and robustness from the post-cleanup code review
    Five independent items surfaced when re-reading the .ino end-to-end.
    Grouped here since each is small and they share the same review.
    1. bGeigie date display showed uptime, not GPS time
    gps_gen_timestamp's bGeigie branch overwrote the local hour/minute
    (cracked from GPS) with uptime values to render the "12h34m" badge.
    The common "Display date" block below then printed those mangled
    values as the time-of-day. Fix: render uptime through fresh locals
    (uph/upm) so the GPS values survive. xGeigie branch was already
    correct because it never touched hour/minute.
    2. LINE_SZ raised 100 -> 120 to cover the BNRDD worst case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
    [bGeigieNano.ino]
2026-05-27 Add Daryl Bender's bGeigie Nano mechanical drawing pack
    12-sheet Pro/ENGINEER drawing pack (BNE02, Issue 02, 2021-09-05)
    covering the enclosure, board stack-up, sensor/GPS/OpenLog positioning,
    and operational interfaces. Sourced from the bGeigieNanoSafecast
    hardware/CAD files folder; renamed for repo conventions.
    Linked from the Assembly section of the README so the docs path is
    complete: bb diagram -> v1.0r4 PCB -> mechanical assembly drawings.
2026-05-27 NANO_DEVICE_ID default 0000 (must be set via SAFECAST.TXT did=)
    The compiled-in default only seeds EEPROM on first boot. SAFECAST.TXT's
    "did=" overrides it on every boot, so a shared firmware shouldn't ship
    with a specific user's id baked in. Forces explicit configuration on
    fresh devices and makes the upstream Safecast convention match.
2026-05-27 Add bGeigie Nano firmware simulator
    Single-file HTML/JS/CSS preview of what the device draws on its 128×32
    OLED and writes to the serial port. No build step, no server, no
    dependencies — open simulator/index.html in any modern browser.
    OLED rendering is pixel-accurate: same 5×7 Adafruit GFX font lifted
    from libraries/Adafruit_GFX/glcdfont.c, same cursor positions and
    field widths as the firmware, same µSv↔mSv switch thresholds, valid
    BNRDD XOR checksums, kit-1.0 HDOP-before-satellites field order.
    Phase breadcrumb walks through SPLASH → BANNER → WAITING_GPS →
    WARMING → RECORDING; the side panel exposes the live state driving
    the display, and the bottom pane streams real $BNR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
2026-05-27 README: add simulator preview screenshot near the top
    A 720-px-wide preview of the firmware simulator (OLED + phase
    breadcrumb + serial log) lands just under the project title, with
    links into simulator/index.html and simulator/README.md. Lifts the
    "what does this thing actually do?" answer above the fold for anyone
    landing on the repo from a website or talk.
